PhamChinhCode/Mini-PID-X2/BOM_MuaHang.csv

STT | Nhóm | Giá trị | Kiểu chân | LCSC | MPN | SL/board | Reference | Thay đổi so với schematic
1 | Điện trở 0603 1% | 10kΩ | 0603 | C25804 | 0603WAF1002T5E | 10 | R1,R3,R5,R7,R8,R17,R18,R19,R20,R28 | R5: 9.53k → 10k (Vout buck ≈ 4,85 V)
2 | Điện trở 0603 1% | 100kΩ | 0603 | C25803 | 0603WAF1003T5E | 2 | R2,R29
3 | Điện trở 0603 1% | 51kΩ | 0603 | C23196 | 0603WAF5102T5E | 1 | R4 | 49.9k → 51k (Vout buck ≈ 4,94 V)
4 | Điện trở 0603 1% | 1kΩ | 0603 | C21190 | 0603WAF1001T5E | 11 | R6,R9,R21,R22,R23,R24,R25,R26,R30,R31,R32 | R21–R24: 100Ω → 1k (lọc encoder fc ≈ 160 kHz)
5 | Điện trở 0603 1% | 1.5kΩ | 0603 | C22843 | 0603WAF1501T5E | 1 | R10
6 | Điện trở 0603 1% | 5.1kΩ | 0603 | C23186 | 0603WAF5101T5E | 5 | R11,R12,R13,R14,R27 | R11,R12: sửa mã LCSC sai (C23162 là 4.7k)
7 | Điện trở 0603 1% | 22kΩ | 0603 | C31850 | 0603WAF2202T5E | 2 | R15,R16
8 | Tụ gốm 0603 | 100nF 50V X7R | 0603 | C14663 | CC0603KRX7R9BB104 | 8 | C2,C4,C5,C10,C11,C12,C14,C16 | C5 (BST): 10nF → 100nF
9 | Tụ gốm 0805 | 10uF 50V X5R | 0805 | C440198 | GRM21BR61H106KE43L | 6 | C3,C6,C7,C13,C20,C22 | C6,C7: 22uF/25V → 10uF/50V; C13: sửa mã (C19666 là gói 0603)
10 | Tụ gốm 0603 | 4.7uF 16V X5R | 0603 | C19666 | CL10A475KO8NNNC | 3 | C8,C9,C15 | C8,C15: 1uF → 4.7uF
11 | Tụ gốm 0603 | 1nF 50V X7R | 0603 | C1588 | CL10B102KB8NNNC | 7 | C23,C24,C25,C26,C27,C28,C29
12 | Tụ gốm 0603 | 20pF 50V C0G | 0603 | C1648 | CL10C200JB8NNNC | 2 | C17,C18
13 | Tụ hóa | 100uF 35V | Radial D6.3 P2.5 | C346956 | NXA35VB100M6.3*11_LO | 1 | C1
14 | Diode | B5819W SL (Schottky 40V 1A) | SOD-123 | C8598 | B5819W SL | 3 | D3,D4,D5
15 | Diode | BZT52C10 (Zener 10V) | SOD-123 | C707140 | BZT52C10 | 1 | D1
16 | Diode | SMAJ18A (TVS) | SMA | C400806 | SMAJ18A | 1 | D2
17 | LED | KT-0603B (xanh dương) | 0603 | C2288 | KT-0603B | 5 | LED1,LED2,LED3,LED4,LED5 | LED1: xanh lá KT-0603G → xanh dương
18 | Cuộn cảm | 10uH | SWPA6045S | C79272 | SWPA6045S100MT | 1 | L1
19 | MOSFET | AONR21357 (P-ch 30V) | DFN-8 3x3 | C431196 | AONR21357 | 1 | Q1
20 | Connector | XT30PW-M30.G.B | XT30 (kiểm tra footprint!) | C30170177 | XT30PW-M30.G.B | 1 | J1 | KIỂM TRA: footprint đang là terminal Phoenix 5.08, không phải XT30
21 | Connector | JST PH 6P ngang | S6B-PH-K | C157920 | S6B-PH-K-S(LF)(SN) | 2 | J2,J3
22 | Connector | USB-C 16P | TYPE-C-31-M-12 | C165948 | TYPE-C-31-M-12 | 1 | J4
23 | Connector | PicoBlade 4P 1.25mm | 53261-0471 | C240847 | 53261-0471 | 2 | J5,J6
24 | Connector | Header 1x4 2.54mm | PinHeader_1x04 | C124378 | B-2100S04P-A110 | 1 | J7
25 | Connector | JST PH 5P ngang | S5B-PH-K | C157923 | S5B-PH-K-S(LF)(SN) | 1 | J8
26 | Nút nhấn | TS-1088-AR02016 | SMD | C720477 | TS-1088-AR02016 | 3 | SW1,SW2,SW3
27 | IC | MP2359DJ-LF-Z (buck 5V) | TSOT-23-6 | C14259 | MP2359DJ-LF-Z | 1 | U1
28 | IC | ME6211C33M5G-N (LDO 3.3V) | SOT-23-5 | C82942 | ME6211C33M5G-N | 1 | U2
29 | IC | STM32F103C8T6 | LQFP-48 | C8734 | STM32F103C8T6 | 1 | U3
30 | IC | DRV8871DDAR | HSOP-8 | C75864 | DRV8871DDAR | 2 | U4,U5
31 | IC | USBLC6-2SC6 (ESD USB) | SOT-23-6 | C7519 | USBLC6-2SC6 | 1 | U6
32 | Thạch anh | 16MHz | 3225 4 chân | C13738 | X322516MLB4SI | 1 | Y1
