PhamChinhCode/Mini-PID-X2/(list of files, drawings)

Other design files:
legacy/MiniPID_Manual.epro
