PhamChinhCode/Mini-PID-X2/MiniPID_Manual.kicad_pcb

## KiCad design MiniPID_Manual.kicad_pcb (2026-11-10)

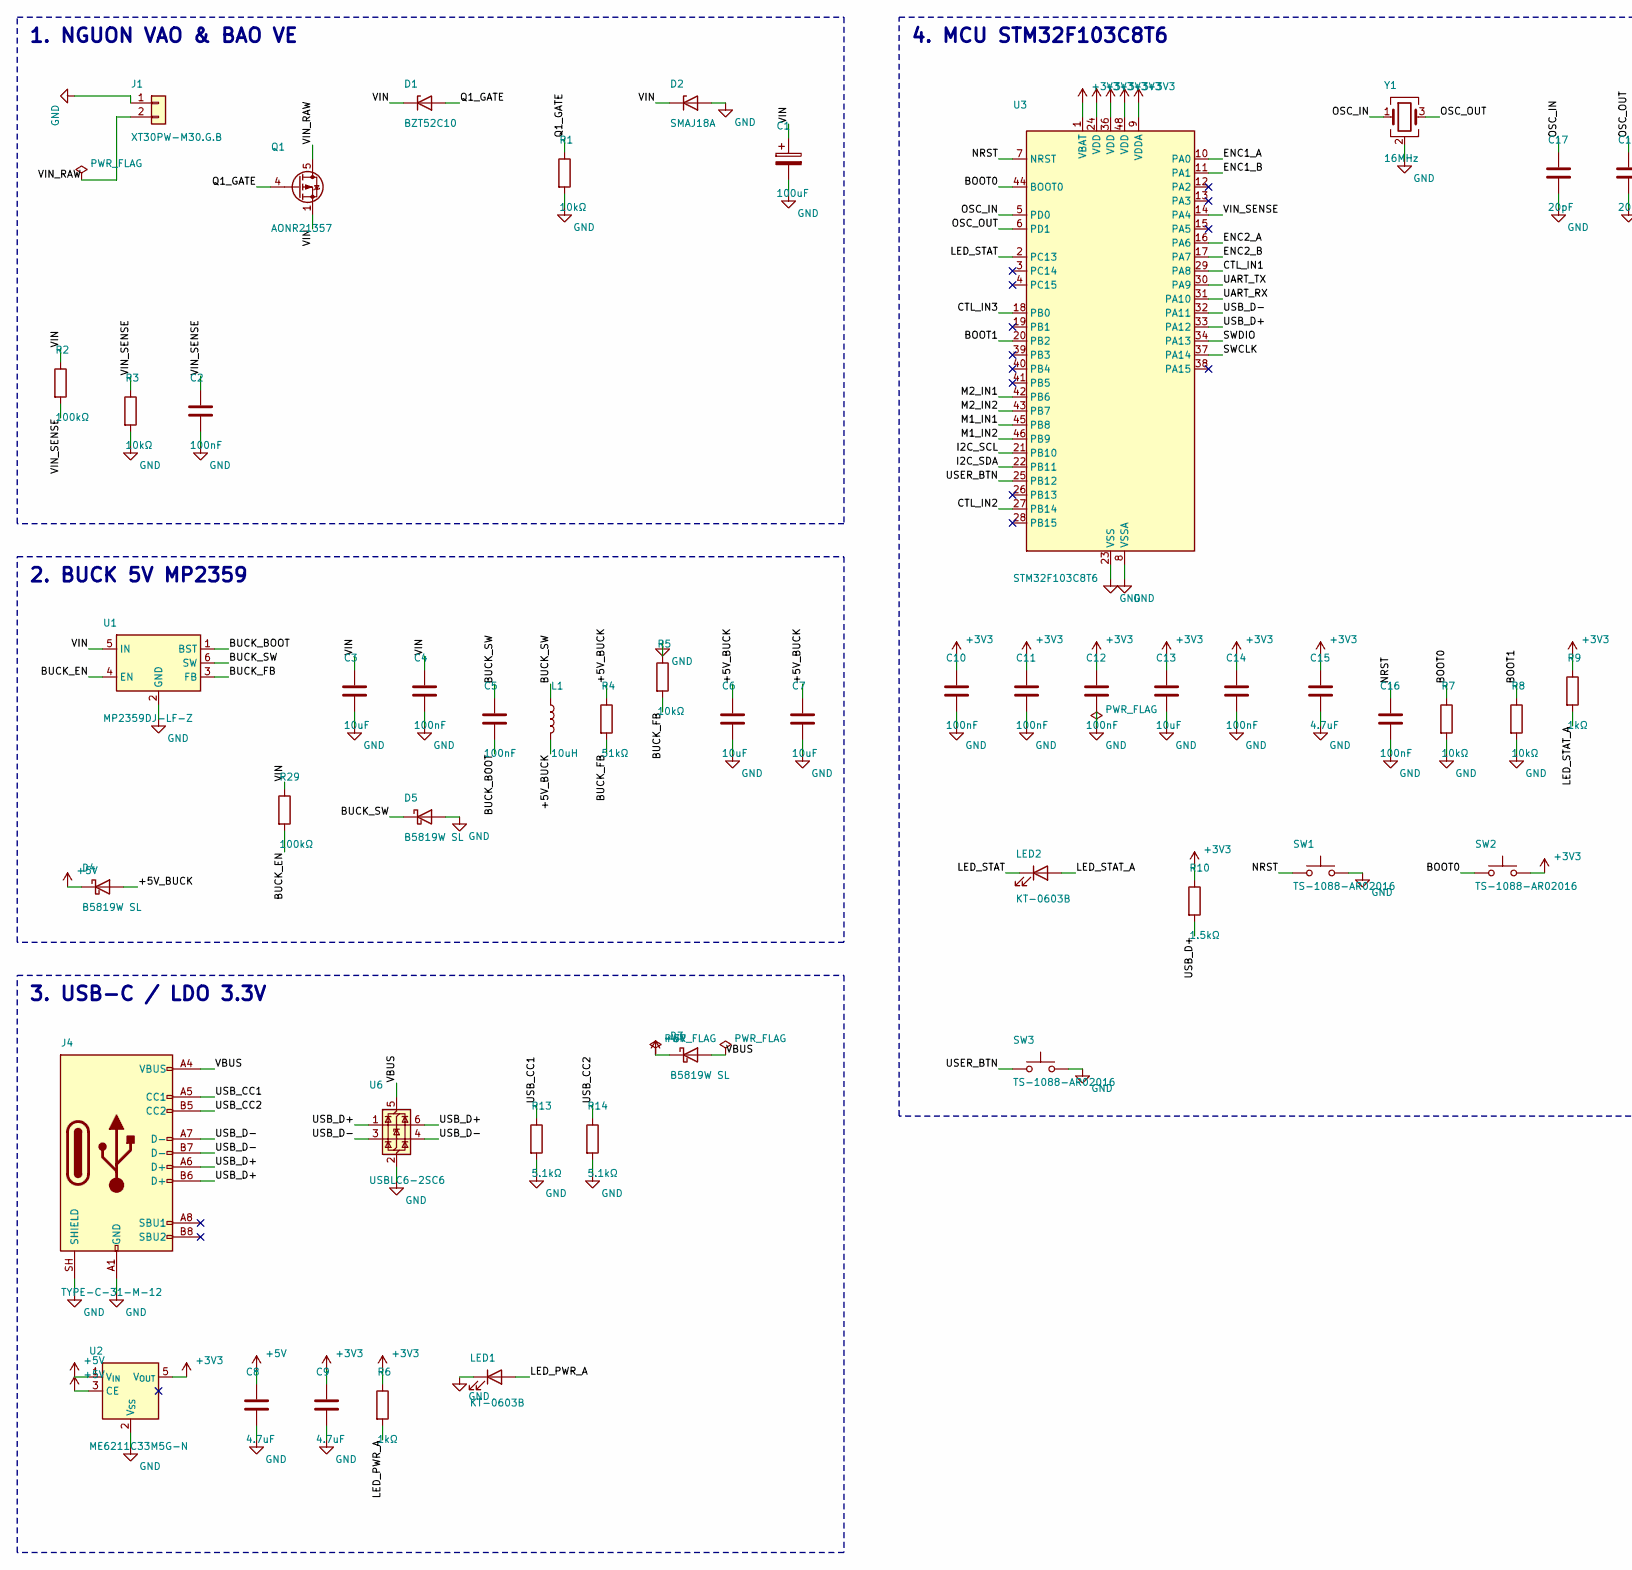
[picture p4: schematic MiniPID_Manual.kicad_sch, MiniPID - 2x DC motor PID controller, part in row 1, column 1]

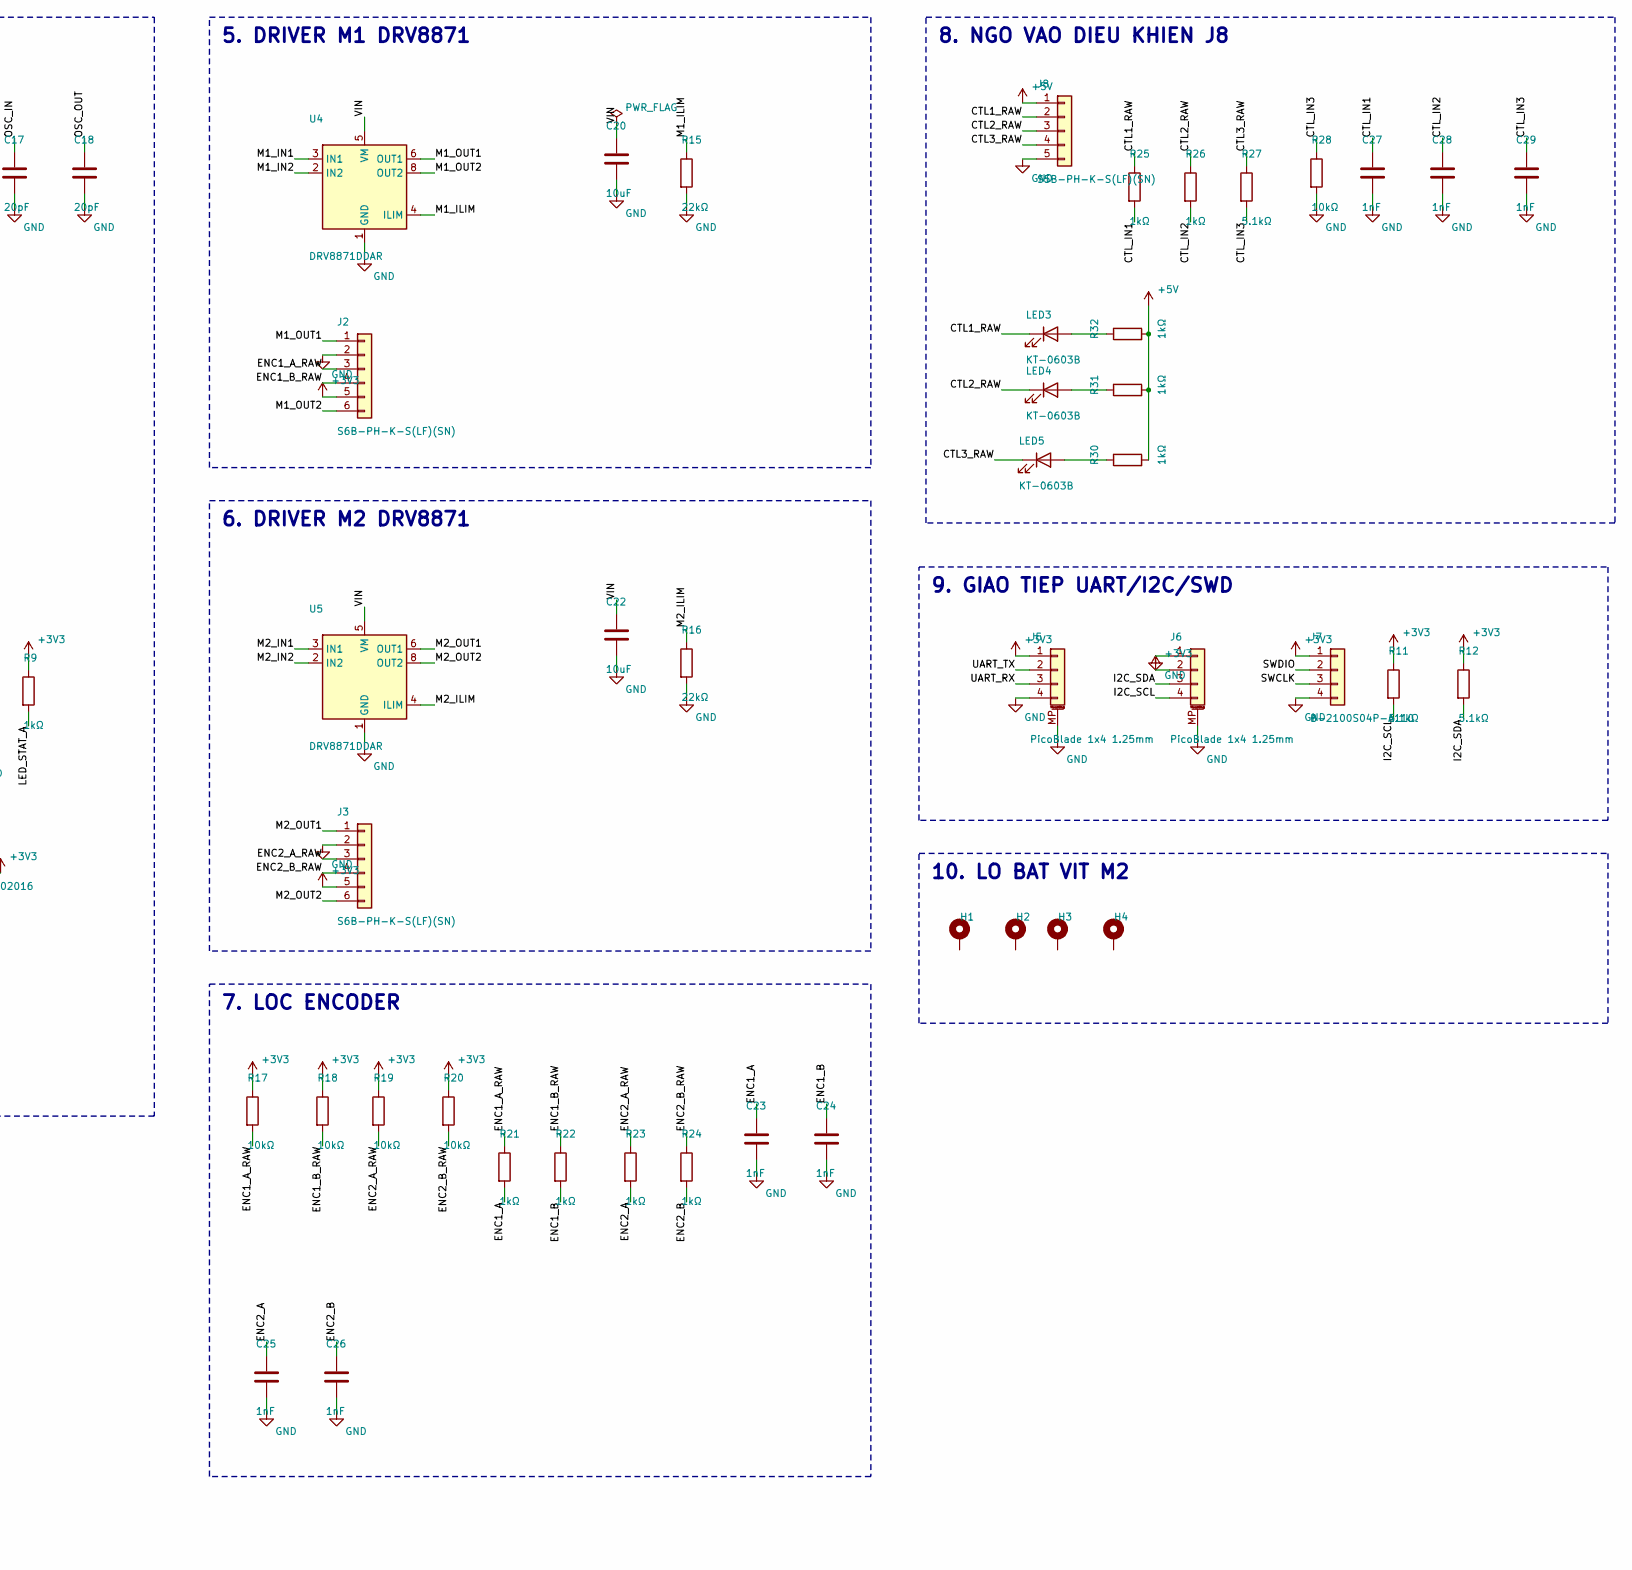
[picture p5: schematic MiniPID_Manual.kicad_sch, MiniPID - 2x DC motor PID controller, part in row 1, column 2]

Parts:
C1: 100uF; CP_Radial_D6.3mm_P2.50mm; MPN NXA35VB100M6.3*11_LO; LCSC C346956
C2, C4, C5, C10, C11, C12, C14, C16: 100nF; C_0603_1608Metric; MPN CC0603KRX7R9BB104; LCSC C14663
C3, C6, C7, C13, C20, C22: 10uF; C_0805_2012Metric; MPN GRM21BR61H106KE43L; LCSC C440198
C8, C9, C15: 4.7uF; C_0603_1608Metric; MPN CL10A475KO8NNNC; LCSC C19666
C17, C18: 20pF; C_0603_1608Metric; MPN CL10C200JB8NNNC; LCSC C1648
C23, C24, C25, C26, C27, C28, C29: 1nF; C_0603_1608Metric; MPN CL10B102KB8NNNC; LCSC C1588
D1: BZT52C10; D_SOD-123; MPN BZT52C10; LCSC C707140
D2: SMAJ18A; D_SMA; MPN SMAJ18A; LCSC C400806
D3, D4, D5: B5819W SL; D_SOD-123; MPN B5819W SL; LCSC C8598
H1, H2, H3, H4: M2; MountingHole_2.2mm_M2_Pad_Via
J1: XT30PW-M30.G.B; TerminalBlock_Phoenix_MKDS-1,5-2-5.08_1x02_P5.08mm_Horizont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; MPN XT30PW-M30.G.B; LCSC C30170177
J2, J3: S6B-PH-K-S(LF)(SN); JST_PH_S6B-PH-K_1x06_P2.00mm_Horizontal; MPN S6B-PH-K-S(LF)(SN); LCSC C157920
J4: TYPE-C-31-M-12; USB_C_Receptacle_HRO_TYPE-C-31-M-12; MPN TYPE-C-31-M-12; LCSC C165948
J5, J6: PicoBlade 1x4 1.25mm; Molex_PicoBlade_53261-0471_1x04-1MP_P1.25mm_Horizontal; MPN 53261-0471; LCSC C240847
J7: B-2100S04P-A110; PinHeader_1x04_P2.54mm_Vertical; MPN B-2100S04P-A110; LCSC C124378
J8: S5B-PH-K-S(LF)(SN); JST_PH_S5B-PH-K_1x05_P2.00mm_Horizontal; MPN S5B-PH-K-S(LF)(SN); LCSC C157923
L1: 10uH; L_Sunlord_SWPA6045S; MPN SWPA6045S100MT; LCSC C79272
LED1, LED2, LED3, LED4, LED5: KT-0603B; LED_0603_1608Metric; MPN KT-0603B; LCSC C2288
Q1: AONR21357; DFN-8-1EP_3x3mm_P0.65mm_EP1.55x2.4mm_EPdrain; MPN AONR21357; LCSC C431196
R1, R3, R5, R7, R8, R17, R18, R19, R20, R28: 10kΩ; R_0603_1608Metric; MPN 0603WAF1002T5E; LCSC C25804
R2, R29: 100kΩ; R_0603_1608Metric; MPN 0603WAF1003T5E; LCSC C25803
R4: 51kΩ; R_0603_1608Metric; MPN 0603WAF4992T5E; LCSC C23184
R6, R9, R21, R22, R23, R24, R25, R26, R30, R31, R32: 1kΩ; R_0603_1608Metric; MPN 0603WAF1001T5E; LCSC C21190
R10: 1.5kΩ; R_0603_1608Metric; MPN 0603WAF1501T5E; LCSC C22843
R11, R12, R13, R14, R27: 5.1kΩ; R_0603_1608Metric; MPN 0603WAF5101T5E; LCSC C23186
R15, R16: 22kΩ; R_0603_1608Metric; MPN 0603WAF2202T5E; LCSC C31850
SW1, SW2, SW3: TS-1088-AR02016; SW_SPST_TS-1088-xR020; MPN TS-1088-AR02016; LCSC C720477
U1: MP2359DJ-LF-Z; TSOT-23-6; MPN MP2359DJ-LF-Z; LCSC C14259
U2: ME6211C33M5G-N; SOT-23-5; MPN ME6211C33M5G-N; LCSC C82942
U3: STM32F103C8T6; LQFP-48_7x7mm_P0.5mm; MPN STM32F103C8T6; LCSC C8734
U4, U5: DRV8871DDAR; Texas_HSOP-8-1EP_3.9x4.9mm_P1.27mm_ThermalVias; MPN DRV8871DDAR; LCSC C75864
U6: USBLC6-2SC6; SOT-23-6; MPN USBLC6-2SC6; LCSC C7519
Y1: 16MHz; Crystal_SMD_3225-4Pin_3.2x2.5mm; MPN X322516MLB4SI; LCSC C13738

Connections:
+3V3: C9.1, C10.1, C11.1, C12.1, C13.1, C14.1, C15.1, J2.5, J3.5, J5.1, J6.2, J7.1, R6.1, R9.1, R10.1, R11.1, R12.1, R17.1, R18.1, R19.1, R20.1, SW2.2, U2.5 (V_{OUT}), U3.1 (VBAT), U3.9 (VDDA), U3.24 (VDD), U3.36 (VDD), U3.48 (VDD)
+5V: C8.1, D3.1 (K), D4.1 (K), J8.1, R30.2, R31.2, R32.2, U2.1 (V_{IN}), U2.3 (CE)
/+5V_BUCK: C6.1, C7.1, D4.2 (A), L1.2, R4.1
/BOOT0: R7.1, SW2.1, U3.44 (BOOT0)
/BOOT1: R8.1, U3.20 (PB2)
/BUCK_BOOT: C5.2, U1.1 (BST)
/BUCK_EN: R29.2, U1.4 (EN)
/BUCK_FB: R4.2, R5.2, U1.3 (FB)
/BUCK_SW: C5.1, D5.1 (K), L1.1, U1.6 (SW)
/CTL1_RAW: J8.2, LED3.1 (K), R25.1
/CTL2_RAW: J8.3, LED4.1 (K), R26.1
/CTL3_RAW: J8.4, LED5.1 (K), R27.1
/CTL_IN1: C27.1, R25.2, U3.29 (PA8)
/CTL_IN2: C28.1, R26.2, U3.27 (PB14)
/CTL_IN3: C29.1, R27.2, R28.1, U3.18 (PB0)
/ENC1_A: C23.1, R21.2, U3.10 (PA0)
/ENC1_A_RAW: J2.3, R17.2, R21.1
/ENC1_B: C24.1, R22.2, U3.11 (PA1)
/ENC1_B_RAW: J2.4, R18.2, R22.1
/ENC2_A: C25.1, R23.2, U3.16 (PA6)
/ENC2_A_RAW: J3.3, R19.2, R23.1
/ENC2_B: C26.1, R24.2, U3.17 (PA7)
/ENC2_B_RAW: J3.4, R20.2, R24.1
/I2C_SCL: J6.4, R11.2, U3.21 (PB10)
/I2C_SDA: J6.3, R12.2, U3.22 (PB11)
/LED_PWR_A: LED1.2 (A), R6.2
/LED_STAT: LED2.1 (K), U3.2 (PC13)
/LED_STAT_A: LED2.2 (A), R9.2
/M1_ILIM: R15.1, U4.4 (ILIM)
/M1_IN1: U3.45 (PB8), U4.3 (IN1)
/M1_IN2: U3.46 (PB9), U4.2 (IN2)
/M1_OUT1: J2.1, U4.6 (OUT1)
/M1_OUT2: J2.6, U4.8 (OUT2)
/M2_ILIM: R16.1, U5.4 (ILIM)
/M2_IN1: U3.42 (PB6), U5.3 (IN1)
/M2_IN2: U3.43 (PB7), U5.2 (IN2)
/M2_OUT1: J3.1, U5.6 (OUT1)
/M2_OUT2: J3.6, U5.8 (OUT2)
/NRST: C16.1, SW1.1, U3.7 (NRST)
/OSC_IN: C17.1, U3.5 (PD0), Y1.1
/OSC_OUT: C18.1, U3.6 (PD1), Y1.3
/Q1_GATE: D1.2 (A), Q1.4 (G), R1.1
/SWCLK: J7.3, U3.37 (PA14)
/SWDIO: J7.2, U3.34 (PA13)
/UART_RX: J5.3, U3.31 (PA10)
/UART_TX: J5.2, U3.30 (PA9)
/USB_CC1: J4.A5 (CC1), R13.1
/USB_CC2: J4.B5 (CC2), R14.1
/USB_D+: J4.A6 (D+), J4.B6 (D+), R10.2, U3.33 (PA12), U6.1 (I/O1), U6.6 (I/O1)
/USB_D-: J4.A7 (D-), J4.B7 (D-), U3.32 (PA11), U6.3 (I/O2), U6.4 (I/O2)
/USER_BTN: SW3.1, U3.25 (PB12)
/VBUS: D3.2 (A), J4.A4 (VBUS), J4.A9 (VBUS), J4.B4 (VBUS), J4.B9 (VBUS), U6.5 (VBUS)
/VIN: C1.1, C3.1, C4.1, C20.1, C22.1, D1.1 (K), D2.1 (K), Q1.1 (S), Q1.2 (S), Q1.3 (S), R2.1, R29.1, U1.5 (IN), U4.5 (VM), U5.5 (VM)
/VIN_RAW: J1.2, Q1.5 (D), Q1.6 (D), Q1.7 (D), Q1.8 (D)
/VIN_SENSE: C2.1, R2.2, R3.1, U3.14 (PA4)
GND: C1.2, C2.2, C3.2, C4.2, C6.2, C7.2, C8.2, C9.2, C10.2, C11.2, C12.2, C13.2, C14.2, C15.2, C16.2, C17.2, C18.2, C20.2, C22.2, C23.2, C24.2, C25.2, C26.2, C27.2, C28.2, C29.2, D2.2 (A), D5.2 (A), J1.1, J2.2, J3.2, J4.A1 (GND), J4.A12 (GND), J4.B1 (GND), J4.B12 (GND), J4.SH (SHIELD), J5.4, J5.MP (MountPin), J6.1, J6.MP (MountPin), J7.4, J8.5, LED1.1 (K), R1.2, R3.2, R5.1, R7.2, R8.2, R13.2, R14.2, R15.2, R16.2, R28.2, SW1.2, SW3.2, U1.2 (GND), U2.2 (V_{SS}), U3.8 (VSSA), U3.23 (VSS), U3.35 (VSS), U3.47 (VSS), U4.1 (GND), U4.7 (GND), U4.9 (GND), U5.1 (GND), U5.7 (GND), U5.9 (GND), U6.2 (GND), Y1.2 (G), Y1.4 (G)
unnamed: LED3.2 (A), R32.1
unnamed: LED4.2 (A), R31.1
unnamed: LED5.2 (A), R30.1

Notes on the sheet:
2. BUCK 5V MP2359
6. DRIVER M2 DRV8871
10. LO BAT VIT M2
4. MCU STM32F103C8T6
9. GIAO TIEP UART/I2C/SWD
8. NGO VAO DIEU KHIEN J8
7. LOC ENCODER
5. DRIVER M1 DRV8871
3. USB-C / LDO 3.3V
1. NGUON VAO & BAO VE

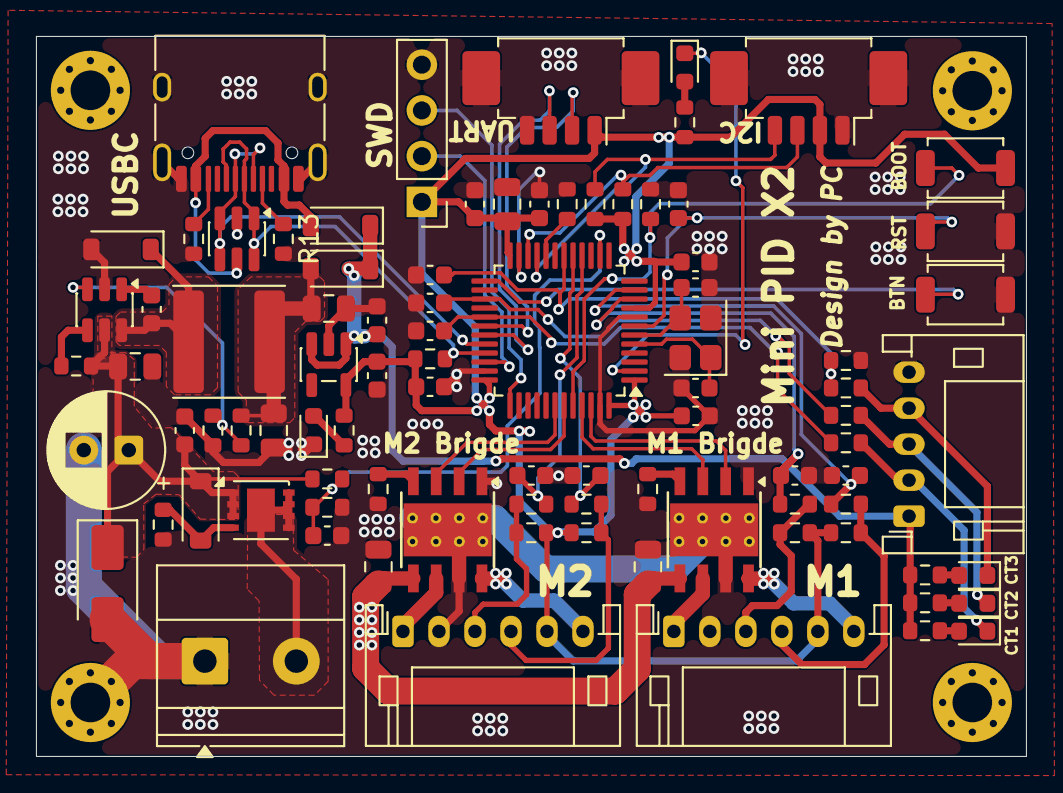
[picture p6: board MiniPID_Manual.kicad_pcb from above]

Board: 2 copper layers, 55.0 x 40.0 mm, 93 parts (0 on the bottom side), 59 nets.
