PhamChinhCode/Mini-PID-X2/(commit log)

2026-11-09 Initial commit: Mini PID X2 KiCad project
    KiCad 10 project for a 2x DC motor PID controller board
    (STM32F103C8T6, 2x DRV8871, MP2359 5V buck, ME6211 3.3V LDO, USB-C).
    Includes schematic, PCB, project libraries, consolidated purchase BOM,
    interactive BOM, Gerber packages, helper CLI tools and legacy EasyEDA
    source files.
    [BOM_MuaHang.csv, MiniPID_Manual.epro, MiniPID_Manual.kicad_pcb, MiniPID_Manual.kicad_sch]
2026-11-10 PCB: R4 51k, update plot settings
    [MiniPID_Manual.kicad_pcb]
2026-11-10 README: add 3D and top/bottom PCB images, update R4 to 51k
    Move the board renders into images/, show them in the README, set R4 to
    51k (C23196) in the purchase BOM and list remaining design to-dos.
    [BOM_MuaHang.csv]
